kvanderlaag/pc104-itx-dlx/README.md

# PC/104-ITX-DLX rev. 0

A PC/104 and ISA SBC Backplane for ITX systems.

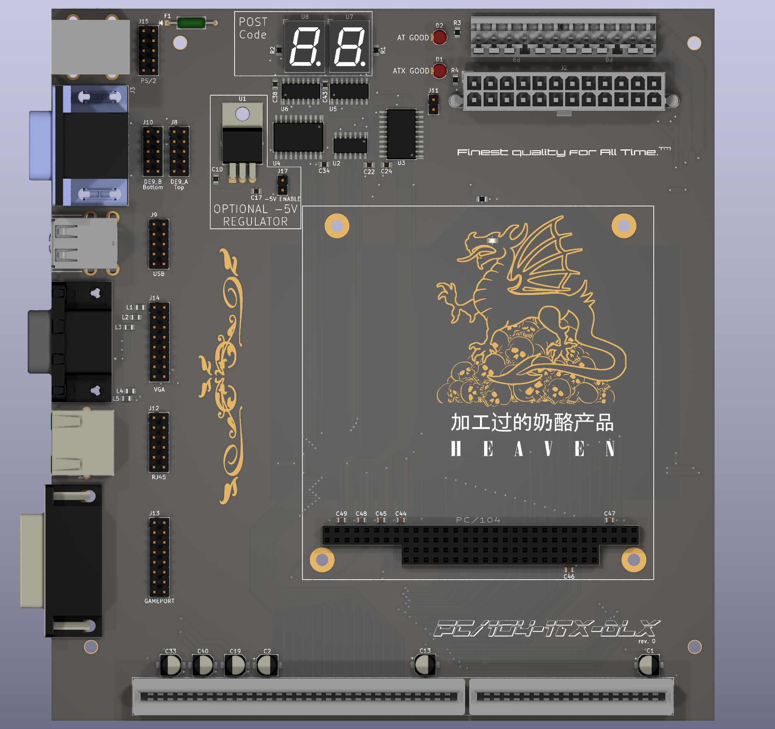
[picture p1: Board-Front.png]
Straight-on view of the board

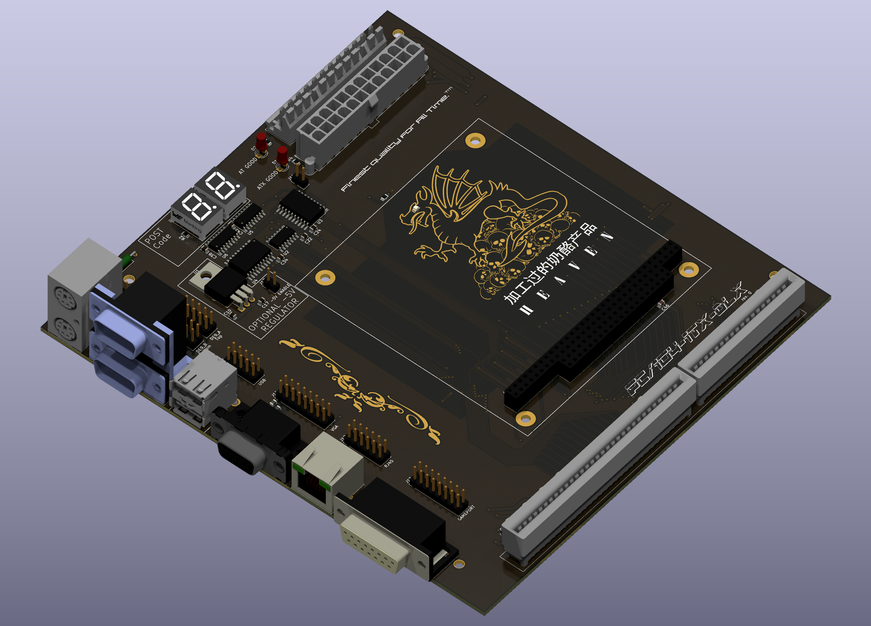
[picture p2: Board-Angled.png]
Angled view of the board
