kvanderlaag/pc104-itx-dlx/pc104-itx-dlx.kicad_sch

## KiCad design pc104-itx-dlx.kicad_sch (2023-04-08)

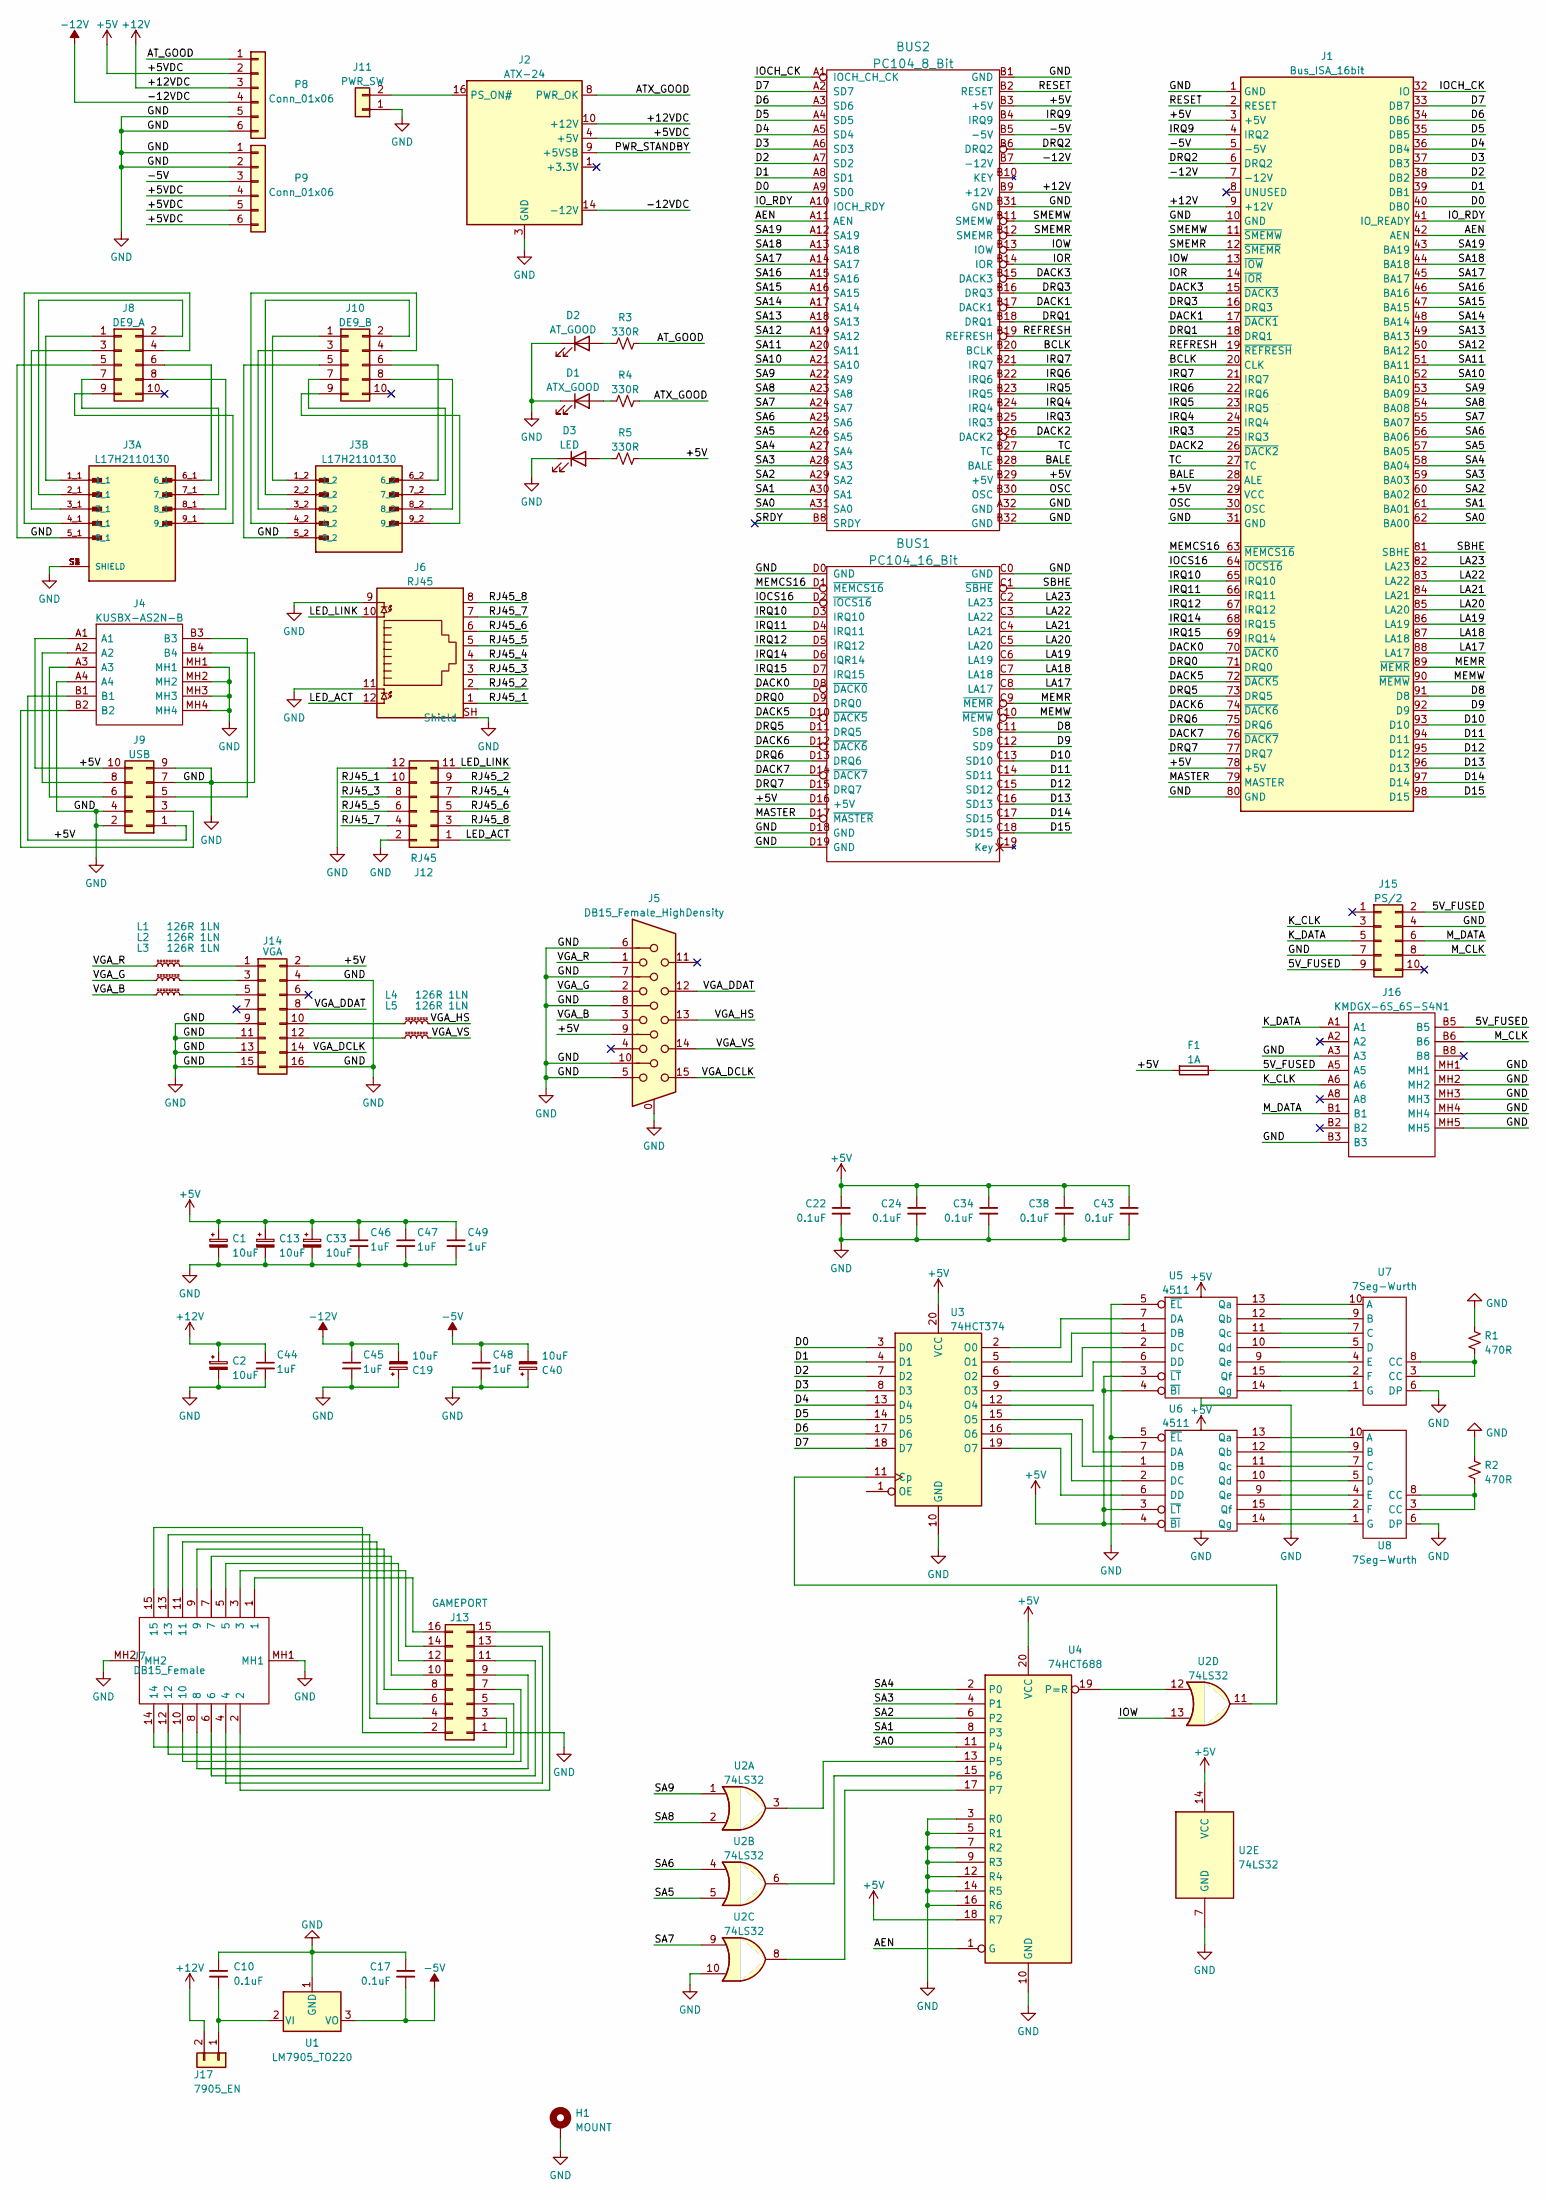
[picture p3: schematic pc104-itx-dlx.kicad_sch]

Parts:
BUS1: PC104_16_Bit; BUS_PC104-16-Bit
BUS2: PC104_8_Bit; BUS_PC104-8-Bit
C1, C2, C13, C19, C33, C40: 10uF; CP_Elec_5x5.3
C10, C17, C22, C24, C34, C38, C43: 0.1uF; C_0805_2012Metric
C44, C45, C46, C47, C48, C49: 1uF; C_0805_2012Metric
D1: ATX_GOOD; LED_D3.0mm_FlatTop
D2: AT_GOOD; LED_D3.0mm_FlatTop
D3: LED; LED_0805_2012Metric
F1: 1A; 0251001.NRT1L
H1: MOUNT; MountingHole
J1: Bus_ISA_16bit; EBC49DCWN-S420
J2: ATX-24; Molex_Mini-Fit_Jr_5566-24A2_2x12_P4.20mm_Vertical
J3: L17H2110130; AMPHENOL_L17H2110130; PARTREV 1
J4: KUSBX-AS2N-B; KUSBXAS2NB; Manufacturer_Part_Number KUSBX-AS2N-B
J5: DB15_Female_HighDensity; ICD15S13E4GX00LF
J6: RJ45; RJ45_Amphenol_RJHSE538X
J7: DB15_Female; ID15S33E4GX00LF; Manufacturer_Part_Number ID15S33E4GX00LF
J8: DE9_A; PinHeader_2x05_P2.54mm_Vertical
J9: USB; PinHeader_2x05_P2.54mm_Vertical
J10: DE9_B; PinHeader_2x05_P2.54mm_Vertical
J11: PWR_SW; PinHeader_1x02_P2.54mm_Vertical
J12: RJ45; PinHeader_2x06_P2.54mm_Vertical
J13: GAMEPORT; PinHeader_2x08_P2.54mm_Vertical
J14: VGA; PinHeader_2x08_P2.54mm_Vertical
J15: PS/2; PinHeader_2x05_P2.54mm_Vertical
J16: KMDGX-6S_6S-S4N1; KMDGX6S6SS4N1; Manufacturer_Part_Number KMDGX-6S/6S-S4N1
J17: 7905_EN; PinHeader_1x02_P2.54mm_Vertical
L1, L2, L3, L4, L5: 126R 1LN; L_0805_2012Metric
P8, P9: Conn_01x06; Molex_366420001
R1, R2: 470R; R_0805_2012Metric
R3, R4, R5: 330R; R_0805_2012Metric
U1: LM7905_TO220; TO-220-3_Horizontal_TabDown
U2: 74LS32
U3: 74HCT374; SOIC-20W_7.5x12.8mm_P1.27mm
U4: 74HCT688; SOIC-20W_7.5x12.8mm_P1.27mm
U5, U6: 4511; SO-16_3.9x9.9mm_P1.27mm
U7, U8: 7Seg-Wurth; Sx39-1xxxxx

Connections:
5V_FUSED: F1.1, J15.2, J15.9, J16.A5, J16.B5
+5V: BUS1.D16 (+5V), BUS2.B3 (+5V), BUS2.B29 (+5V), C1.1, C13.1, C22.1, C24.1, C33.1, C34.1, C38.1, C43.1, C46.1, C47.1, C49.1, F1.2, J1.3 (+5V), J1.29 (VCC), J1.78 (+5V), J2.4 (+5V), J2.6 (+5V), J2.21 (+5V), J2.22 (+5V), J2.23 (+5V), J4.A1, J4.B1, J5.9, J9.1, J9.10, J14.2, P8.2, P9.4, P9.5, P9.6, R5.2, U2.14 (VCC), U3.20 (VCC), U4.18 (R7), U4.20 (VCC), U5.3 (~LT), U5.4 (~BI), U5.16 (Vdd), U6.3 (~LT), U6.4 (~BI), U6.16 (Vdd)
+12V: BUS2.B9 (+12V), C2.1, C44.1, J1.9 (+12V), J2.10 (+12V), J2.11 (+12V), J17.2, P8.3
-5V: BUS2.B5 (-5V), C17.2, C40.2, C48.1, J1.5 (-5V), P9.3, U1.3 (VO)
-12V: BUS2.B7 (-12V), C19.2, C45.1, J1.7 (-12V), J2.14 (-12V), P8.4
AEN: BUS2.A11 (AEN), J1.42 (AEN), U4.1 (G)
ATX_GOOD: J2.8 (PWR_OK), R4.2
AT_GOOD: P8.1, R3.2
BALE: BUS2.B28 (BALE), J1.28 (ALE)
BCLK: BUS2.B20 (BCLK), J1.20 (CLK)
D0: BUS2.A9 (SD0), J1.40 (DB0), U3.3 (D0)
D1: BUS2.A8 (SD1), J1.39 (DB1), U3.4 (D1)
D2: BUS2.A7 (SD2), J1.38 (DB2), U3.7 (D2)
D3: BUS2.A6 (SD3), J1.37 (DB3), U3.8 (D3)
D4: BUS2.A5 (SD4), J1.36 (DB4), U3.13 (D4)
D5: BUS2.A4 (SD5), J1.35 (DB5), U3.14 (D5)
D6: BUS2.A3 (SD6), J1.34 (DB6), U3.17 (D6)
D7: BUS2.A2 (SD7), J1.33 (DB7), U3.18 (D7)
D8: BUS1.C11 (SD8), J1.91 (D8)
D9: BUS1.C12 (SD9), J1.92 (D9)
D10: BUS1.C13 (SD10), J1.93 (D10)
D11: BUS1.C14 (SD11), J1.94 (D11)
D12: BUS1.C15 (SD12), J1.95 (D12)
D13: BUS1.C16 (SD13), J1.96 (D13)
D14: BUS1.C17 (SD15), J1.97 (D14)
D15: BUS1.C18 (SD15), J1.98 (D15)
DACK0: BUS1.D8 (~DACK0), J1.70 (~DACK0)
DACK1: BUS2.B17 (DACK1), J1.17 (~DACK1)
DACK2: BUS2.B26 (DACK2), J1.26 (~DACK2)
DACK3: BUS2.B15 (DACK3), J1.15 (~DACK3)
DACK5: BUS1.D10 (~DACK5), J1.72 (~DACK5)
DACK6: BUS1.D12 (~DACK6), J1.74 (~DACK6)
DACK7: BUS1.D14 (~DACK7), J1.76 (~DACK7)
DRQ0: BUS1.D9 (DRQ0), J1.71 (DRQ0)
DRQ1: BUS2.B18 (DRQ1), J1.18 (DRQ1)
DRQ2: BUS2.B6 (DRQ2), J1.6 (DRQ2)
DRQ3: BUS2.B16 (DRQ3), J1.16 (DRQ3)
DRQ5: BUS1.D11 (DRQ5), J1.73 (DRQ5)
DRQ6: BUS1.D13 (DRQ6), J1.75 (DRQ6)
DRQ7: BUS1.D15 (DRQ7), J1.77 (DRQ7)
GND: BUS1.C0 (GND), BUS1.D0 (GND), BUS1.D18 (GND), BUS1.D19 (GND), BUS2.A32 (GND), BUS2.B1 (GND), BUS2.B31 (GND), BUS2.B32 (GND), C1.2, C2.2, C10.1, C13.2, C17.1, C19.1, C22.2, C24.2, C33.2, C34.2, C38.2, C40.1, C43.2, C44.2, C45.2, C46.2, C47.2, C48.2, C49.2, D1.1 (K), D2.1 (K), D3.1 (K), H1.1, J1.1 (GND), J1.10 (GND), J1.31 (GND), J1.80 (GND), J2.3 (GND), J2.5 (GND), J2.7 (GND), J2.15 (GND), J2.17 (GND), J2.18 (GND), J2.19 (GND), J2.24 (GND), J3.5_1, J3.5_2, J3.S1 (SHIELD), J3.S2 (SHIELD), J3.S3 (SHIELD), J3.S4 (SHIELD), J4.A4, J4.B4, J4.MH1, J4.MH2, J4.MH3, J4.MH4, J5.0 (Shield), J5.5, J5.6, J5.7, J5.8, J5.10, J6.9, J6.11, J6.SH (Shield), J7.MH1, J7.MH2, J8.5, J9.2, J9.4, J9.7, J9.9, J10.5, J11.1, J12.2, J12.12, J13.1, J14.4, J14.9, J14.11, J14.13, J14.15, J14.16, J15.4, J15.7, J16.A3, J16.B3, J16.MH1, J16.MH2, J16.MH3, J16.MH4, J16.MH5, P8.5, P8.6, P9.1, P9.2, R1.1, R2.1, U1.1 (GND), U2.7 (GND), U2.10, U3.10 (GND), U4.3 (R0), U4.5 (R1), U4.7 (R2), U4.9 (R3), U4.10 (GND), U4.12 (R4), U4.14 (R5), U4.16 (R6), U5.5 (~EL), U5.8 (Vss), U6.5 (~EL), U6.8 (Vss), U7.6 (DP), U8.6 (DP)
IOCH_CK: BUS2.A1 (IOCH_CH_CK), J1.32 (IO)
IOCS16: BUS1.D2 (~IOCS16), J1.64 (~IOCS16)
IOR: BUS2.B14 (IOR), J1.14 (~IOR)
IOW: BUS2.B13 (IOW), J1.13 (~IOW), U2.13
IO_RDY: BUS2.A10 (IOCH_RDY), J1.41 (IO_READY)
IRQ3: BUS2.B25 (IRQ3), J1.25 (IRQ3)
IRQ4: BUS2.B24 (IRQ4), J1.24 (IRQ4)
IRQ5: BUS2.B23 (IRQ5), J1.23 (IRQ5)
IRQ6: BUS2.B22 (IRQ6), J1.22 (IRQ6)
IRQ7: BUS2.B21 (IRQ7), J1.21 (IRQ7)
IRQ9: BUS2.B4 (IRQ9), J1.4 (IRQ2)
IRQ10: BUS1.D3 (IRQ10), J1.65 (IRQ10)
IRQ11: BUS1.D4 (IRQ11), J1.66 (IRQ11)
IRQ12: BUS1.D5 (IRQ12), J1.67 (IRQ12)
IRQ14: BUS1.D6 (IQR14), J1.68 (IRQ15)
IRQ15: BUS1.D7 (IRQ15), J1.69 (IRQ14)
K_CLK: J15.3, J16.A6
K_DATA: J15.5, J16.A1
LA17: BUS1.C8 (LA17), J1.88 (LA17)
LA18: BUS1.C7 (LA18), J1.87 (LA18)
LA19: BUS1.C6 (LA19), J1.86 (LA19)
LA20: BUS1.C5 (LA20), J1.85 (LA20)
LA21: BUS1.C4 (LA21), J1.84 (LA21)
LA22: BUS1.C3 (LA22), J1.83 (LA22)
LA23: BUS1.C2 (LA23), J1.82 (LA23)
LED_ACT: J6.12, J12.1
LED_LINK: J6.10, J12.11
MASTER: BUS1.D17 (~MASTER), J1.79 (MASTER)
MEMCS16: BUS1.D1 (~MEMCS16), J1.63 (~MEMCS16)
MEMR: BUS1.C9 (~MEMR), J1.89 (~MEMR)
MEMW: BUS1.C10 (~MEMW), J1.90 (~MEMW)
M_CLK: J15.8, J16.B6
M_DATA: J15.6, J16.B1
unnamed: C10.2, J17.1, U1.2 (VI)
unnamed: D1.2 (A), R4.1
unnamed: D2.2 (A), R3.1
unnamed: D3.2 (A), R5.1
unnamed: J2.1 (+3.3V), J2.2 (+3.3V), J2.12 (+3.3V), J2.13 (+3.3V)
unnamed: J3.1_1, J8.1
unnamed: J3.2_1, J8.2
unnamed: J3.3_1, J8.3
unnamed: J3.4_1, J8.4
unnamed: J3.6_1, J8.6
unnamed: J3.7_1, J8.7
unnamed: J3.8_1, J8.8
unnamed: J3.9_1, J8.9
unnamed: J4.A2, J9.8
unnamed: J4.A3, J9.6
unnamed: J4.B2, J9.3
unnamed: J4.B3, J9.5
unnamed: J3.1_2, J10.1
unnamed: J3.2_2, J10.2
unnamed: J3.3_2, J10.3
unnamed: J3.4_2, J10.4
unnamed: J3.6_2, J10.6
unnamed: J3.7_2, J10.7
unnamed: J3.8_2, J10.8
unnamed: J3.9_2, J10.9
unnamed: J2.16 (PS_ON#), J11.2
unnamed: J7.15, J13.2
unnamed: J7.14, J13.3
unnamed: J7.13, J13.4
unnamed: J7.12, J13.5
unnamed: J7.11, J13.6
unnamed: J7.10, J13.7
unnamed: J7.9, J13.8
unnamed: J7.8, J13.9
unnamed: J7.7, J13.10
unnamed: J7.6, J13.11
unnamed: J7.5, J13.12
unnamed: J7.4, J13.13
unnamed: J7.3, J13.14
unnamed: J7.2, J13.15
unnamed: J7.1, J13.16
unnamed: J14.1, L1.2
unnamed: J14.3, L2.2
unnamed: J14.5, L3.2
unnamed: J14.10, L4.1
unnamed: J14.12, L5.1
unnamed: R1.2, U7.3 (CC), U7.8 (CC)
unnamed: R2.2, U8.3 (CC), U8.8 (CC)
unnamed: U2.3, U4.13 (P5)
unnamed: U2.6, U4.15 (P6)
unnamed: U2.8, U4.17 (P7)
unnamed: U2.11, U3.11 (Cp)
unnamed: U2.12, U4.19 (P=R)
unnamed: U3.2 (O0), U5.7 (DA)
unnamed: U3.5 (O1), U5.1 (DB)
unnamed: U3.6 (O2), U5.2 (DC)
unnamed: U3.9 (O3), U5.6 (DD)
unnamed: U3.12 (O4), U6.7 (DA)
unnamed: U3.15 (O5), U6.1 (DB)
unnamed: U3.16 (O6), U6.2 (DC)
unnamed: U3.19 (O7), U6.6 (DD)
unnamed: U5.9 (Qe), U7.4 (E)
unnamed: U5.10 (Qd), U7.5 (D)
unnamed: U5.11 (Qc), U7.7 (C)
unnamed: U5.12 (Qb), U7.9 (B)
unnamed: U5.13 (Qa), U7.10 (A)
unnamed: U5.14 (Qg), U7.1 (G)
unnamed: U5.15 (Qf), U7.2 (F)
unnamed: U6.9 (Qe), U8.4 (E)
unnamed: U6.10 (Qd), U8.5 (D)
unnamed: U6.11 (Qc), U8.7 (C)
unnamed: U6.12 (Qb), U8.9 (B)
unnamed: U6.13 (Qa), U8.10 (A)
unnamed: U6.14 (Qg), U8.1 (G)
unnamed: U6.15 (Qf), U8.2 (F)
OSC: BUS2.B30 (OSC), J1.30 (OSC)
PWR_STANDBY: J2.9 (+5VSB)
REFRESH: BUS2.B19 (REFRESH), J1.19 (~REFRESH)
RESET: BUS2.B2 (RESET), J1.2 (RESET)
RJ45_1: J6.1, J12.10
RJ45_2: J6.2, J12.9
RJ45_3: J6.3, J12.8
RJ45_4: J6.4, J12.7
RJ45_5: J6.5, J12.6
RJ45_6: J6.6, J12.5
RJ45_7: J6.7, J12.4
RJ45_8: J6.8, J12.3
SA0: BUS2.A31 (SA0), J1.62 (BA00), U4.11 (P4)
SA1: BUS2.A30 (SA1), J1.61 (BA01), U4.8 (P3)
SA2: BUS2.A29 (SA2), J1.60 (BA02), U4.6 (P2)
SA3: BUS2.A28 (SA3), J1.59 (BA03), U4.4 (P1)
SA4: BUS2.A27 (SA4), J1.58 (BA04), U4.2 (P0)
SA5: BUS2.A26 (SA5), J1.57 (BA05), U2.5
SA6: BUS2.A25 (SA6), J1.56 (BA06), U2.4
SA7: BUS2.A24 (SA7), J1.55 (BA07), U2.9
SA8: BUS2.A23 (SA8), J1.54 (BA08), U2.2
SA9: BUS2.A22 (SA9), J1.53 (BA09), U2.1
SA10: BUS2.A21 (SA10), J1.52 (BA10)
SA11: BUS2.A20 (SA11), J1.51 (BA11)
SA12: BUS2.A19 (SA12), J1.50 (BA12)
SA13: BUS2.A18 (SA13), J1.49 (BA13)
SA14: BUS2.A17 (SA14), J1.48 (BA14)
SA15: BUS2.A16 (SA15), J1.47 (BA15)
SA16: BUS2.A15 (SA16), J1.46 (BA16)
SA17: BUS2.A14 (SA17), J1.45 (BA17)
SA18: BUS2.A13 (SA18), J1.44 (BA18)
SA19: BUS2.A12 (SA19), J1.43 (BA19)
SBHE: BUS1.C1 (~SBHE), J1.81 (SBHE)
SMEMR: BUS2.B12 (SMEMR), J1.12 (~SMEMR)
SMEMW: BUS2.B11 (SMEMW), J1.11 (~SMEMW)
SRDY: BUS2.B8 (SRDY)
TC: BUS2.B27 (TC), J1.27 (TC)
VGA_B: J5.3, L3.1
VGA_DCLK: J5.15, J14.14
VGA_DDAT: J5.12, J14.8
VGA_G: J5.2, L2.1
VGA_HS: J5.13, L4.2
VGA_R: J5.1, L1.1
VGA_VS: J5.14, L5.2
